Heke03/APF-FPGA/docs/figures/fig3_spectrum.png

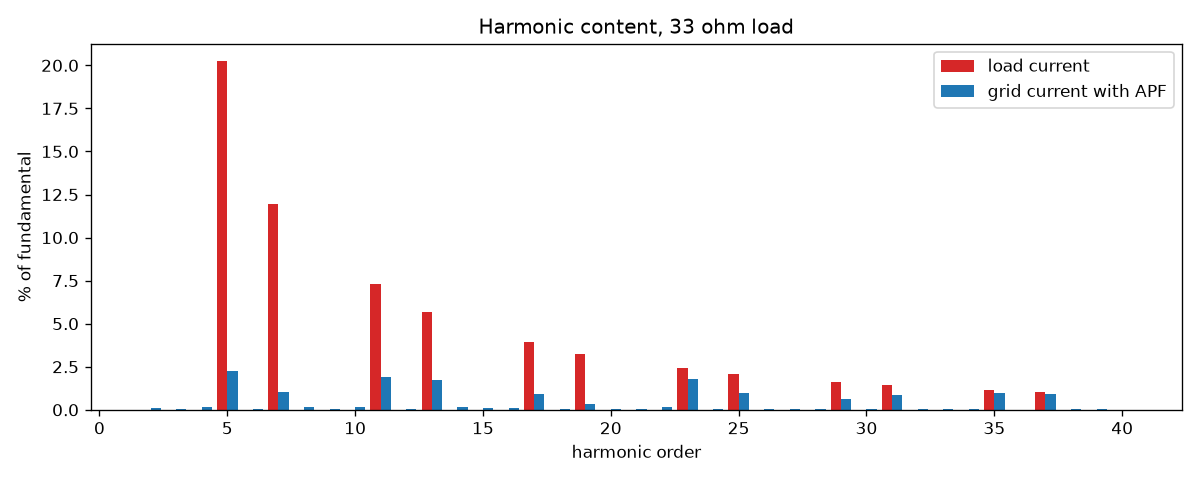
docs/figures/fig3_spectrum.png
