Heke03/APF-FPGA/docs/figures/H3_vps_vs_simscape.png

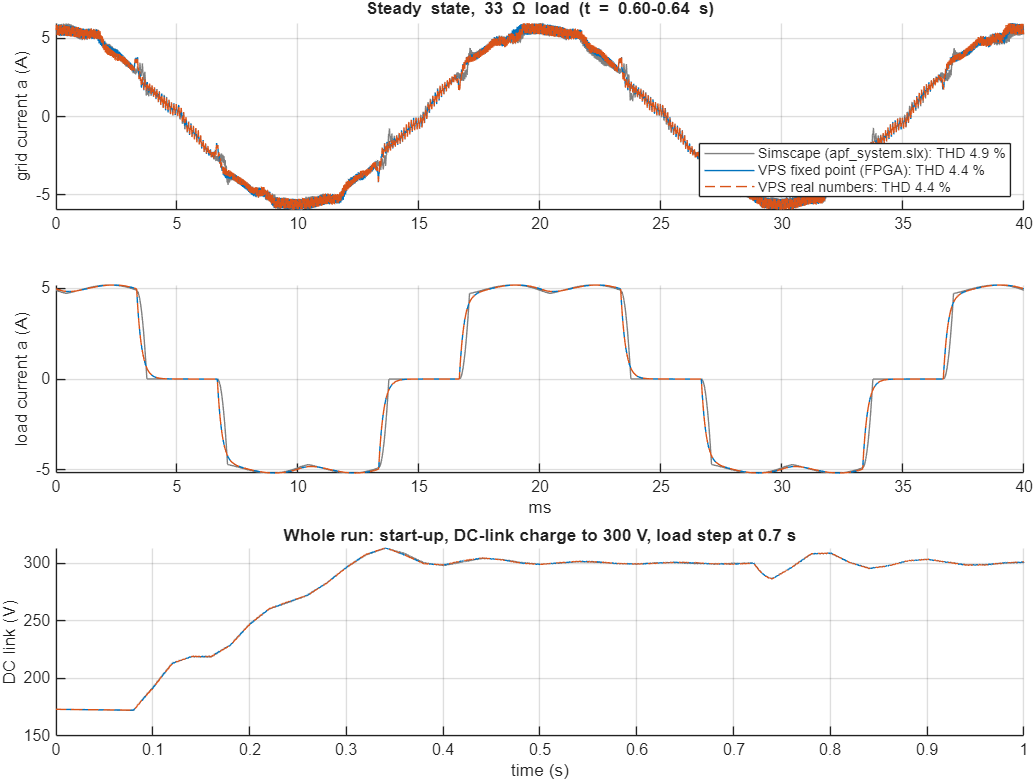
docs/figures/H3_vps_vs_simscape.png
