Heke03/APF-FPGA/docs/figures/simulink/fig1_waveforms.png

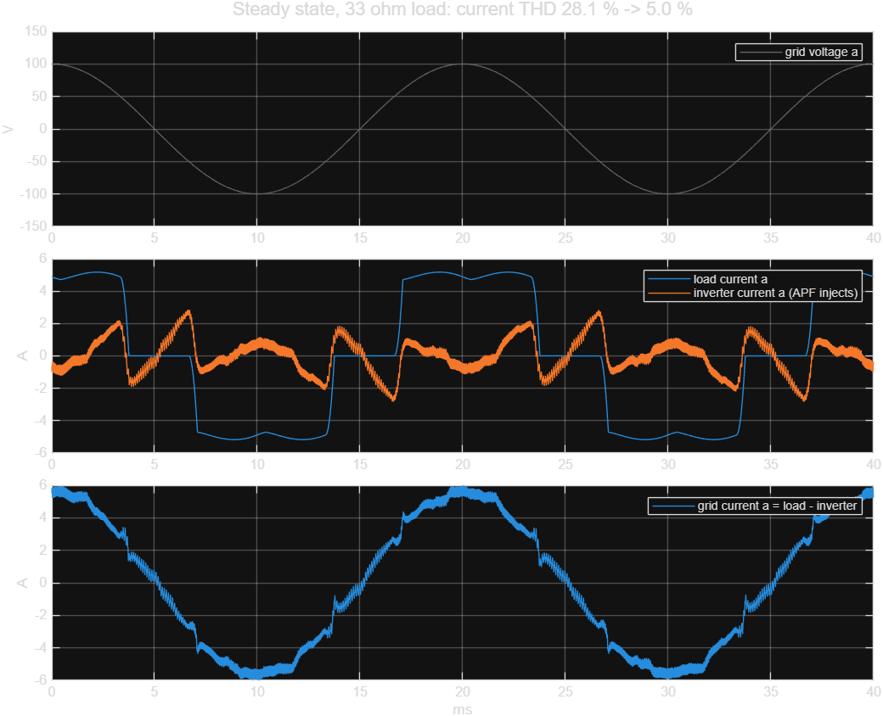
docs/figures/simulink/fig1_waveforms.png
