Heke03/APF-FPGA/docs/figures/simulink/fig2_startup.png

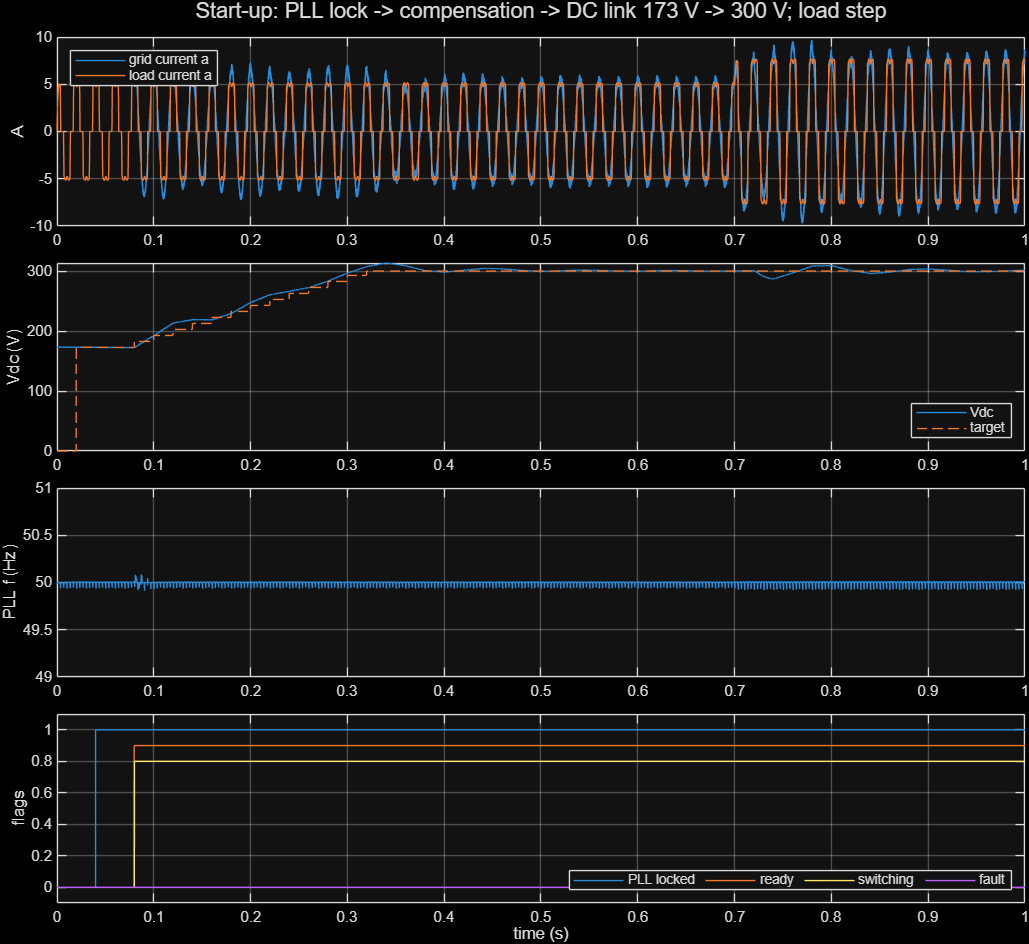
docs/figures/simulink/fig2_startup.png
