Heke03/APF-FPGA/docs/figures/simulink/fig3_spectrum.png

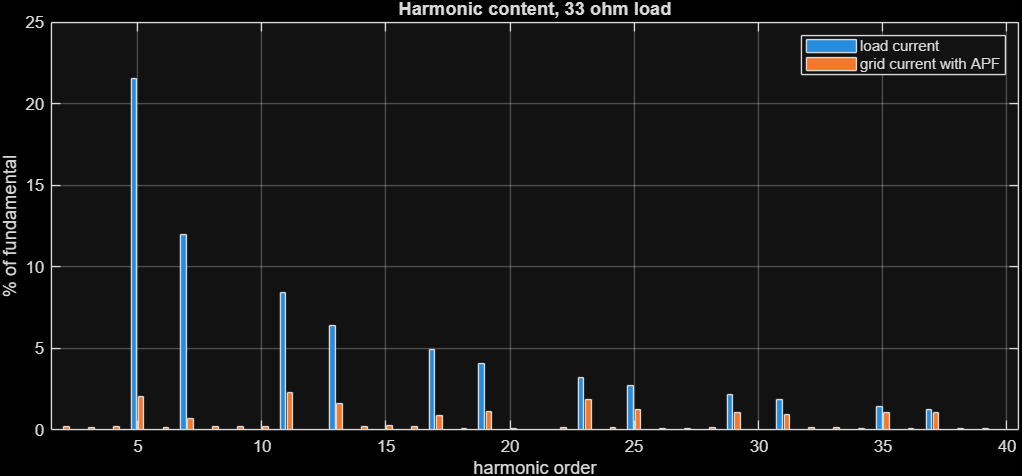
docs/figures/simulink/fig3_spectrum.png
