Heke03/APF-FPGA/docs/figures/simulink/model_controller.png

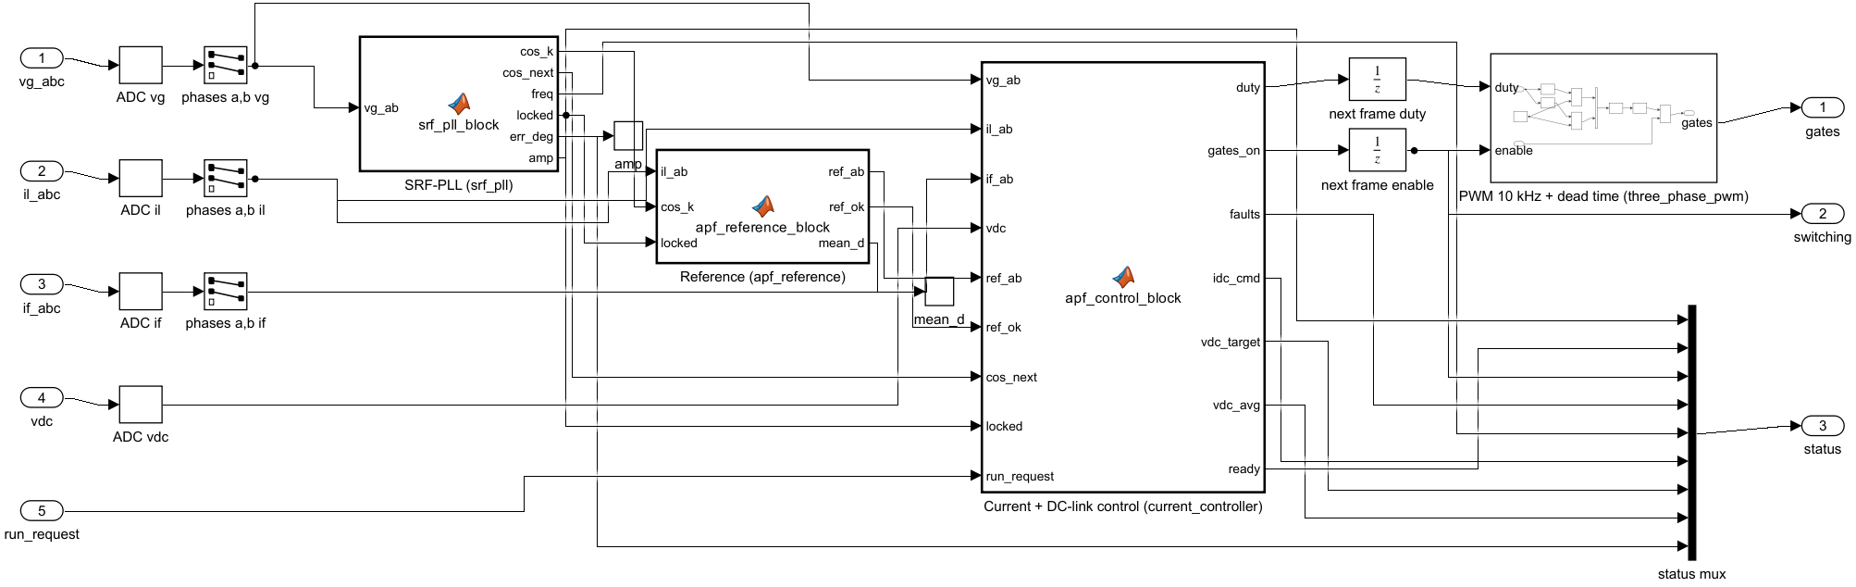
docs/figures/simulink/model_controller.png
