Heke03/APF-FPGA/docs/figures/fig4_load_step.png

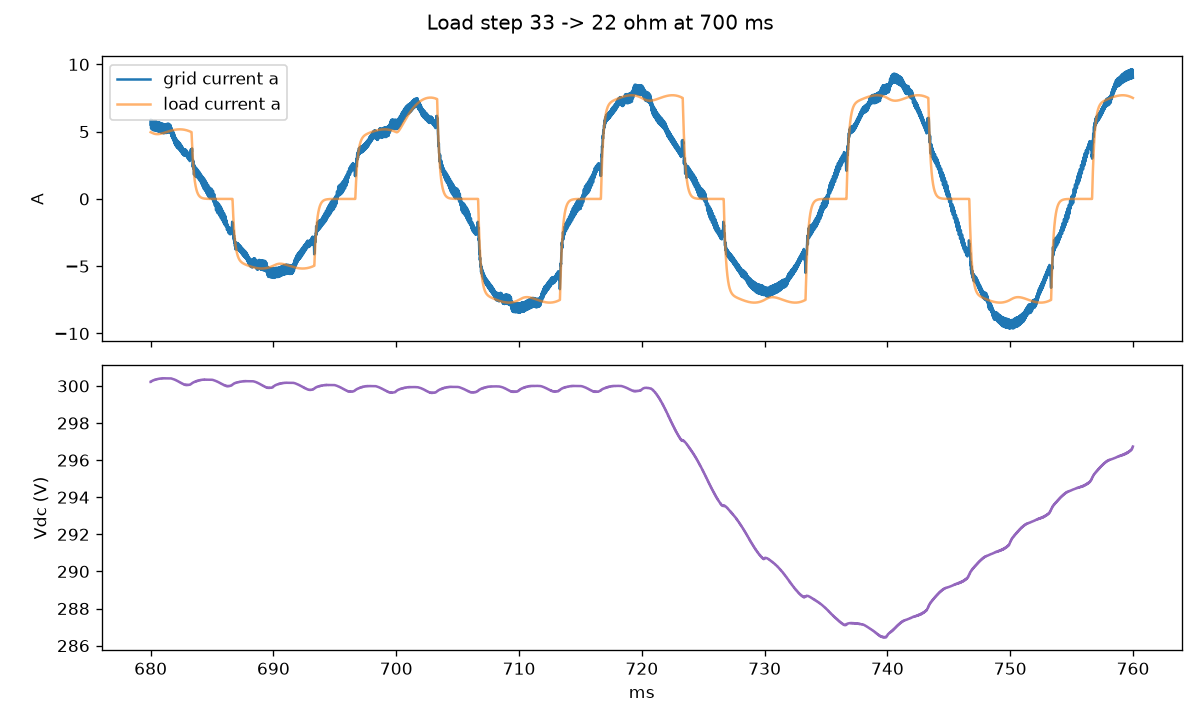
docs/figures/fig4_load_step.png
