Heke03/APF-FPGA/docs/figures/simulink/fig4_load_step.png

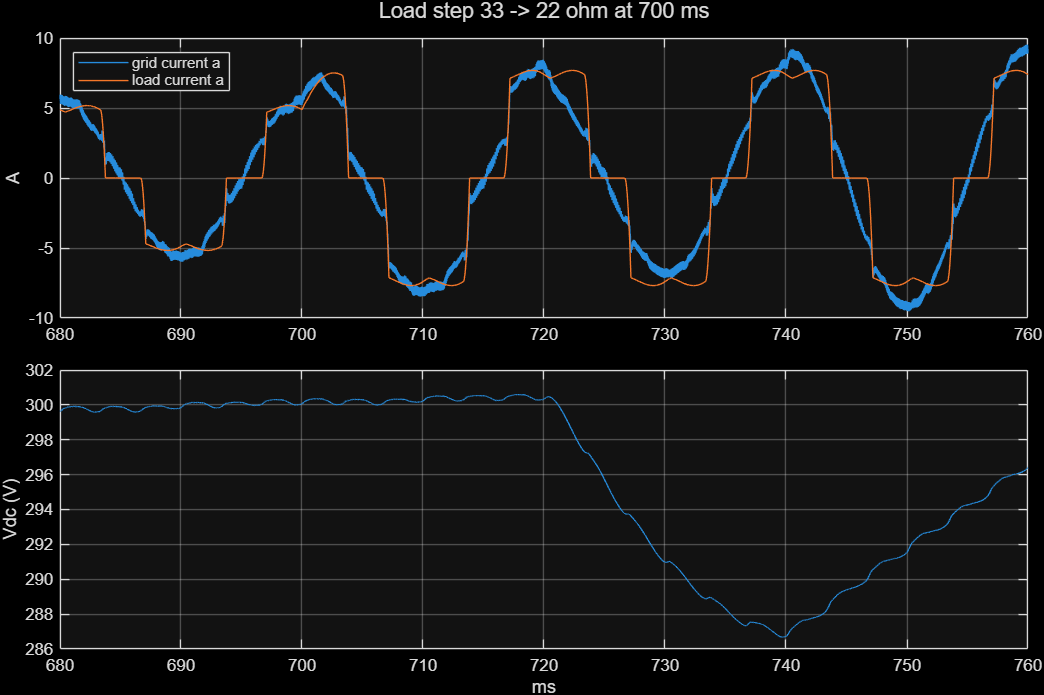
docs/figures/simulink/fig4_load_step.png
