Heke03/APF-FPGA/docs/sensor_adc_study_H2_results.csv

chain | description | thd33_pct | std33 | thd22_pct | std22 | vdc_dip_V | faults
S0_ideal | Ideal sensors, 12-bit ADC | 4.89 | 0.12 | 3.61 | 0.08 | 13.3 | 0000
S1_LEM_AD7606 | LEM LV 25-P + LA 25-NP, AD7606 (simultaneous) | 4.91 | 0.08 | 3.6 | 0.07 | 13.2 | 0000
S2_LEM_LTC2308 | LEM sensors, LTC2308 (multiplexed, 2 us/ch) | 4.91 | 0.09 | 3.63 | 0.04 | 14.4 | 0000
S3_isoamp_AD7606 | Isolated-amp voltage + LA 25-NP, AD7606 | 4.94 | 0.2 | 3.6 | 0.07 | 13.4 | 0000
S4_cRIO_NI9215 | LEM sensors, cRIO NI 9215 + link to DE2-115 | 4.91 | 0.08 | 3.6 | 0.07 | 13.2 | 0000
S5_cRIO_NI9244 | cRIO NI 9244/9246 delta-sigma (0.8 ms delay) | 28.09 | 0 | 27.46 | 0 | 92.9 | 0011
S6_LEM_AD7606_noisy | As S1 with 3 counts rms noise | 4.87 | 0.08 | 3.58 | 0.05 | 13.9 | 0000
S7_delay100us | As S1 + 100 us extra delay | 8.2 | 0.15 | 6.71 | 0.03 | 13.8 | 0000
S8_delay200us | As S1 + 200 us extra delay | 16.86 | 0.16 | 16.52 | 0.13 | 13.5 | 0000
S9_delay400us | As S1 + 400 us extra delay | 32.99 | 0.61 | 49.18 | 0.47 | 15.5 | 0000
S10_LEM_AD7606_real | LEM + AD7606 +-5 V, all real lags | 5.01 | 0.22 | 3.55 | 0.12 | 13.1 | 0000
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
