Heke03/APF-FPGA/(commit log)

2026-10-22 FPGA control for a three-phase shunt active power filter (DE1-SoC)
    SRF-PLL, compensation reference, deadbeat current controller with DC-link loop, PWM, measurement front end, top level, unit testbenches and a closed-loop Questa system simulation.
2026-10-22 Add Simulink model of the full APF (switching power stage + apf_core controller)
    matlab/apf_system.slx mirrors the RTL block for block (SRF-PLL, reference,
    current/DC-link control, 10 kHz PWM with dead time) with an IGBT inverter
    and diode-bridge load. Grid current THD 5.0 % / 3.6 % (RTL sim 4.6 % / 3.5 %).
    Includes parameter file, MATLAB Function block sources, a rebuild script,
    the run/analysis scripts, result figures and a README section.
2026-10-30 H1: sensor and ADC study for the DE2-115 board
    The lab board is a DE2-115 (Cyclone IV E), which has no usable ADC, and the
    lab also has an NI cRIO-9063. Every sensor/ADC option was simulated in closed
    loop with the real apf_core RTL:
    - sim/tb_apf_system_H1.sv: system testbench with an optional measurement
    chain (sensor lag, delay before the sample, multiplexer skew, delivery
    time, noise, seed). With no options it reproduces tb_apf_system bit for bit.
    - sim/run_sensor_study_H1.do: the 16 scenarios.
    - matlab/sensor_adc_study_H1.m: steady-state THD table, repeatability check,
    figures. matlab/frontend_sizing_H1.m: LEM resistor sizing and limits.
    - docs/sensor_adc_study_H1.md: results and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
    [tb_apf_system_H1.sv]
2026-10-31 H2: sensor and ADC study in Simulink
    Same 16 measurement chains as H1, run in the switching Simulink model
    (apf_system_H2.slx = apf_system.slx + "Sensors + ADC (H2)" block), plus a
    0-200 us delay sweep with two noise seeds. With an ideal ADC the new model
    matches apf_system.slx exactly. Same ranking as H1; the AD7606/AD7606B on
    the +-10 V range stays recommended.
    [sensor_adc_study_H2_results.csv]
2026-10-31 H3 step 1: virtual power stage model in MATLAB/Simulink
    The grid, diode-bridge load and inverter in integer (fixed-point) math, as
    they will run inside the DE2-115 FPGA, so the controller can run in closed
    loop on the board with nothing connected. apf_vps_H3.slx = the unchanged
    controller of apf_system.slx + this plant. Fixed point vs real numbers
    differ by <1 mA open loop and <=0.03 THD points closed loop; THD 4.43/3.50 %
    (33/22 ohm), same as the H1 RTL testbench. Progress: docs/H3_progress.md.
2026-10-31 H3 step 2: virtual power stage in FPGA code
    - rtl/virtual_power_stage_H3.sv: the grid, diode-bridge load and inverter
    computed in the FPGA, one step per 200 ns, same integers as vps_block_H3.m
    - rtl/vps_adc_H3.sv: ADC stand-in (20 us conversion, optional noise)
    - rtl/apf_vps_system_H3.sv: apf_core + VPS + ADC, the base of the DE2-115 top
    - Bit-exact against MATLAB: 200,000 steps, 0 mismatches
    - Closed loop in Questa, 1 s: grid THD 4.40 % / 3.51 %, no faults, no shoot-through
    - Cyclone V timing at 50 MHz: +2.98 ns after pipelining the Vdc update
    [apf_vps_system_H3.sv, tb_apf_vps_H3.sv, tb_vps_H3.sv, virtual_power_stage_H3.sv, vps_adc_H3.sv]
2026-10-31 H3 step 3: Cyclone IV E timing on the DE2-115 chip
    Cyclone IV E device support is installed. The first compile of
    apf_vps_system_H3 on EP4CE115F29C7 fit easily (7 % logic, 34 % multipliers)
    but missed 50 MHz by 1.43 ns at the 85 C corner. Three calculations were
    each done in a single clock; they are now split, with the same math:
    - current_controller.sv: DC-link PI over DC_LOOP, DC_INTEG, DC_CMD
    - srf_pll.sv: PI, frequency and angle advance over LOOP, FREQ, ADVANCE
    - virtual_power_stage_H3.sv: the idq-independent part of the load current
    update moves to ph 7; the rounding constant is folded into the add
    Now +1.93 ns at 85 C. PLL test 11,000 frames bit-exact, VPS test 200,000
    steps 0 mism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
    [current_controller.sv, srf_pll.sv, virtual_power_stage_H3.sv]
2026-10-31 H3: Live Script walkthrough of the virtual power stage data and math
    vps_walkthrough_H3.m runs everything that is not a simulation: plant data,
    the FPGA integer constants and what rounding does to them, the cosine table,
    one plant step, 40 ms of plant steps (plotted), ADC codes, and the FPGA vs
    Simulink comparison; then opens the code in the Editor. vps_vectors_H3 now
    also returns its table.
2026-10-31 H3 step 3 part 1: THD meter math for the board display
    thd_meter_H3.m: per-harmonic DFT (h 1..40) over 1000 frame samples with
    a 200-point cos/sin table, whole-number math as the FPGA will do it.
    Matches the FFT THD within 0.05-0.2 points on the 1 s VPS run.
2026-10-31 H3 step 3 parts 2-4: DE2-115 board design with THD display
    - rtl/thd_meter_H3.sv: THD of grid current a every 0.1 s, bit-exact with
    matlab/thd_meter_H3.m (table rtl/thd_table_200.hex from thd_vectors_H3.m)
    - rtl/apf_vps_system_H3.sv: holds the meter (sampled on adc_start) and the
    peak grid current
    - rtl/display_H3.sv: 8 digits, DC link left, one reading right; the DE2-115
    has no decimal point, so it is shown as "_" (4_40 = 4.40 %)
    - rtl/de2_115_top_H3.sv: KEY0 reset, SW0..SW4 debounced, LEDs, displays
    - quartus/de2_115_pins_H3.tcl: 106 pins from Terasic's DE2-115 pin list;
    build_de2_115_H3.ps1 builds the .sof, unused pins as inputs.
    EP4CE115F29C7: 9 % logic, +1.77 ns setup at 85 C,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
    [apf_vps_system_H3.sv, de2_115_top_H3.sv, display_H3.sv, tb_de2_115_H3.sv, tb_display_H3.sv, tb_thd_meter_H3.sv, thd_meter_H3.sv]
2026-10-31 H3 step 3 part 5: waveform recorder read over JTAG
    - rtl/capture_H3.sv: records grid/load/inverter current, DC link and grid
    voltage every 100 us in 5 x 16384-sample memories; flipping SW0-SW2
    triggers it, it stops half a memory later (LEDG8), KEY1 re-arms.
    Memories are readable while the design runs (In-System Memory Content
    Editor), so no Signal Tap setup is needed.
    - quartus/read_capture_H3.tcl: reads the recording with quartus_stp.
    - matlab/load_capture_H3.m, capture_check_H3.m: load and verify a recording.
    - Board testbench: 18/18 checks; both recordings match the THD meter's
    samples bit for bit and give the same readings as the board display.
    - Build: 10 % LEs, 37 % memory bi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
    [apf_vps_system_H3.sv, capture_H3.sv, de2_115_top_H3.sv, tb_de2_115_H3.sv, tb_thd_meter_H3.sv, thd_meter_H3.sv]
